Vassar-Robot-Competition-2018/teamB/README.md

# Team Renegades

Team Theme: (https://www.youtube.com/watch?v=8j741TUIET0)

Group Members:
- Steven Park
- Wenxuan Guo
- Shihan Zhao

To Do:
- Work on Milestone 4
- Work on Milestone 6
