Vassar-Robot-Competition-2018/teamB/Code/Modelling/3D printing/lower2.stl

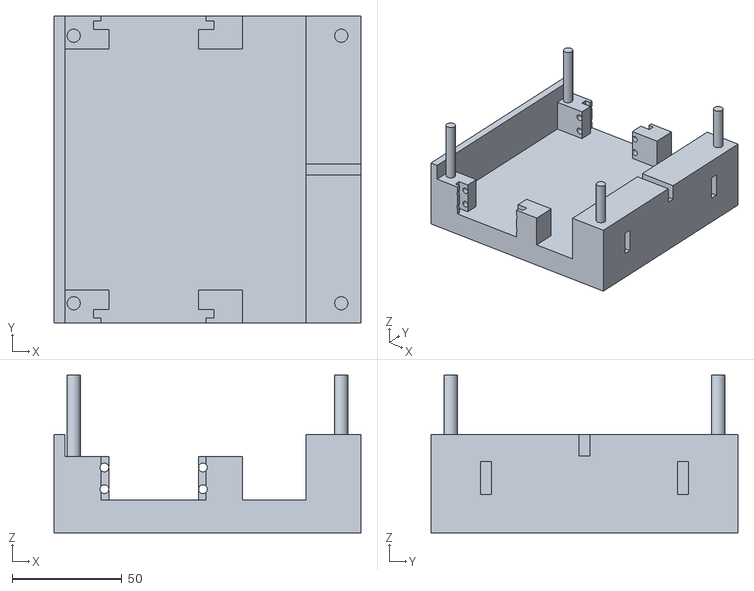
[picture p33: CAD file, 2018-04-28]
Code/Modelling/3D printing/lower2.stl
140.0 x 140.0 x 72.0
