Vassar-Robot-Competition-2018/teamB/Code/Modelling/Camera Board.stl

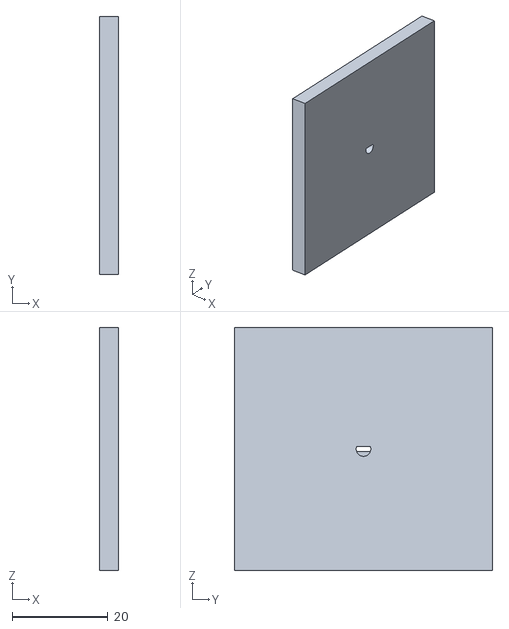
[picture p34: CAD file, 2018-04-10]
Code/Modelling/Camera Board.stl
4.00 x 53.8 x 50.8
