Vassar-Robot-Competition-2018/teamB/Code/Modelling/final design/lower2.stl

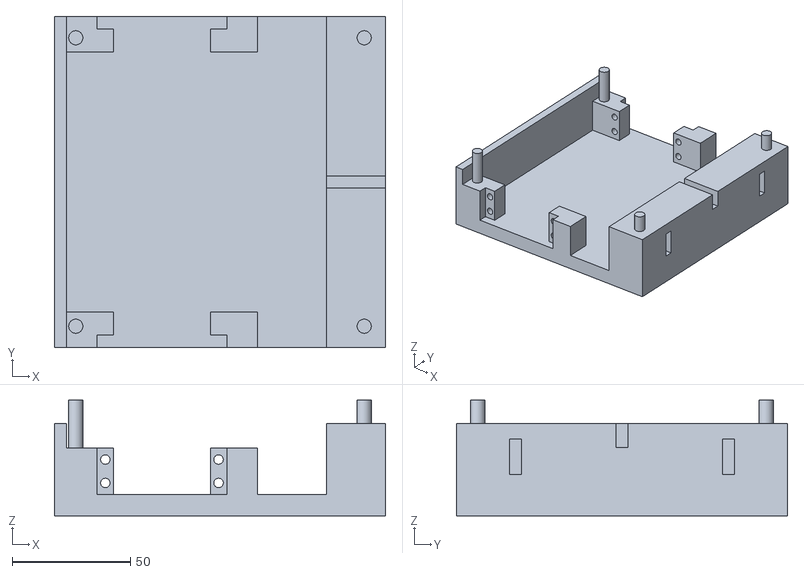
[picture p35: CAD file, 2018-04-28]
Code/Modelling/final design/lower2.stl
140.0 x 140.0 x 49.0
