Vassar-Robot-Competition-2018/teamB/Code/Modelling/3D printing/Model upper.stl

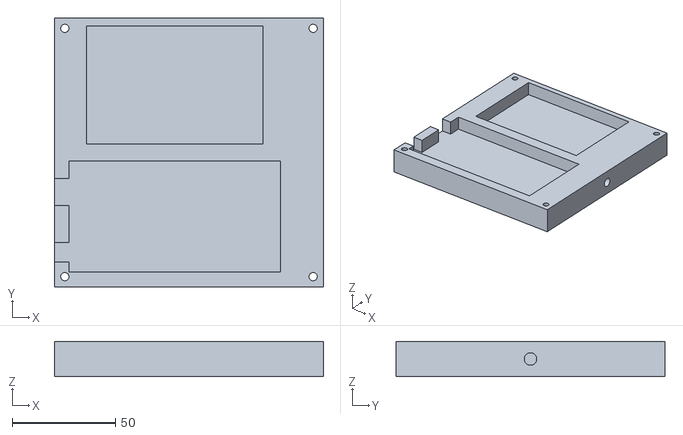
[picture p36: CAD file, 2018-04-10]
Code/Modelling/3D printing/Model upper.stl
130.0 x 130.0 x 17.0
