Vassar-Robot-Competition-2018/teamB/Code/Modelling/final design/Model upper.stl

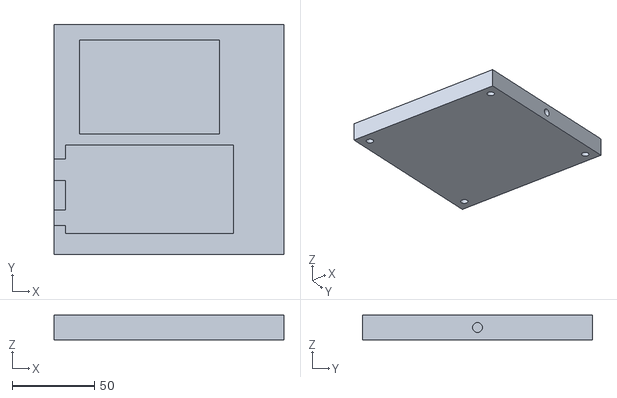
[picture p37: CAD file, 2018-04-28]
Code/Modelling/final design/Model upper.stl
140.0 x 140.0 x 15.0
