Vassar-Robot-Competition-2018/teamB/(list of files, cad)

Other CAD files:
Code/Modelling/Model lower.scad
Code/Modelling/Model upper.scad
Code/Modelling/Model.scad
Code/Modelling/Variable_List.scad
Code/Modelling/final design/lower2.scad
Code/Modelling/final design/Model upper.scad
Code/Version 1.0/COGS 220 robot.3dm
