Vassar-Robot-Competition-2018/teamB/(commit log)

2018-02-06 QRE
    Code for lIne sensor
2018-02-10 camera works
2018-02-12 Week 2
    Progress for week 2, including journal update.
    [COGS 220 robot.3dm]
2018-02-13 added switch and LED
2018-02-17 IR Sensor
2018-02-17 Sensor Testing
2018-02-23 RGB sensor
2018-04-03 3D model
    [Model 1.scad, Variable List.scad]
2018-04-05 Modelling Part2
    [Camera Board.scad, Columns * 4.scad, Model.scad, Nut * 8.scad, Variable_List.scad, servo_attach.scad]
2018-04-10 additional photos
    [Camera Board.scad]
2018-04-17 New changes on model
    [Model lower.scad, Model upper.scad, front wheels.scad, lower2.scad]
2018-04-29 the 3D printer didn't corporate
